stustanet/Luftmeter/PCB/luftmeter.jpg

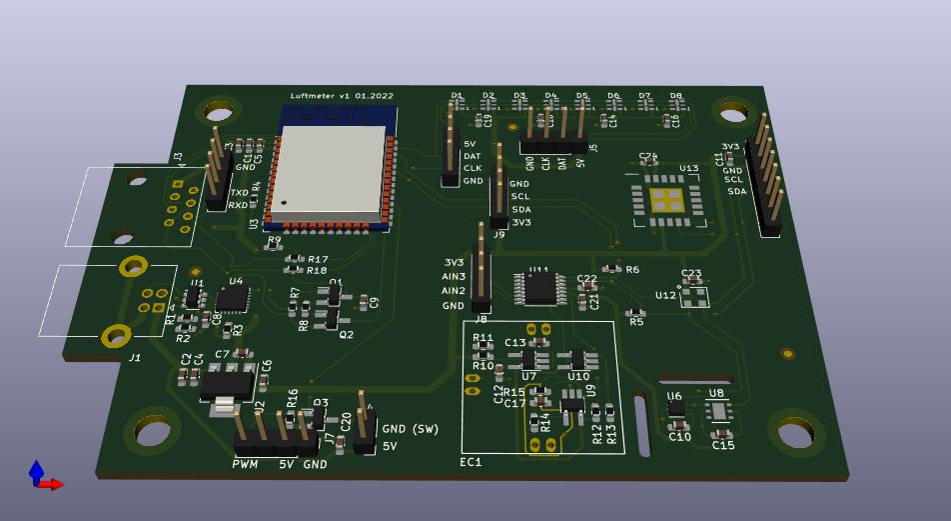
PCB/luftmeter.jpg
