stustanet/Luftmeter/PCB/plots/luftmeter.pdf

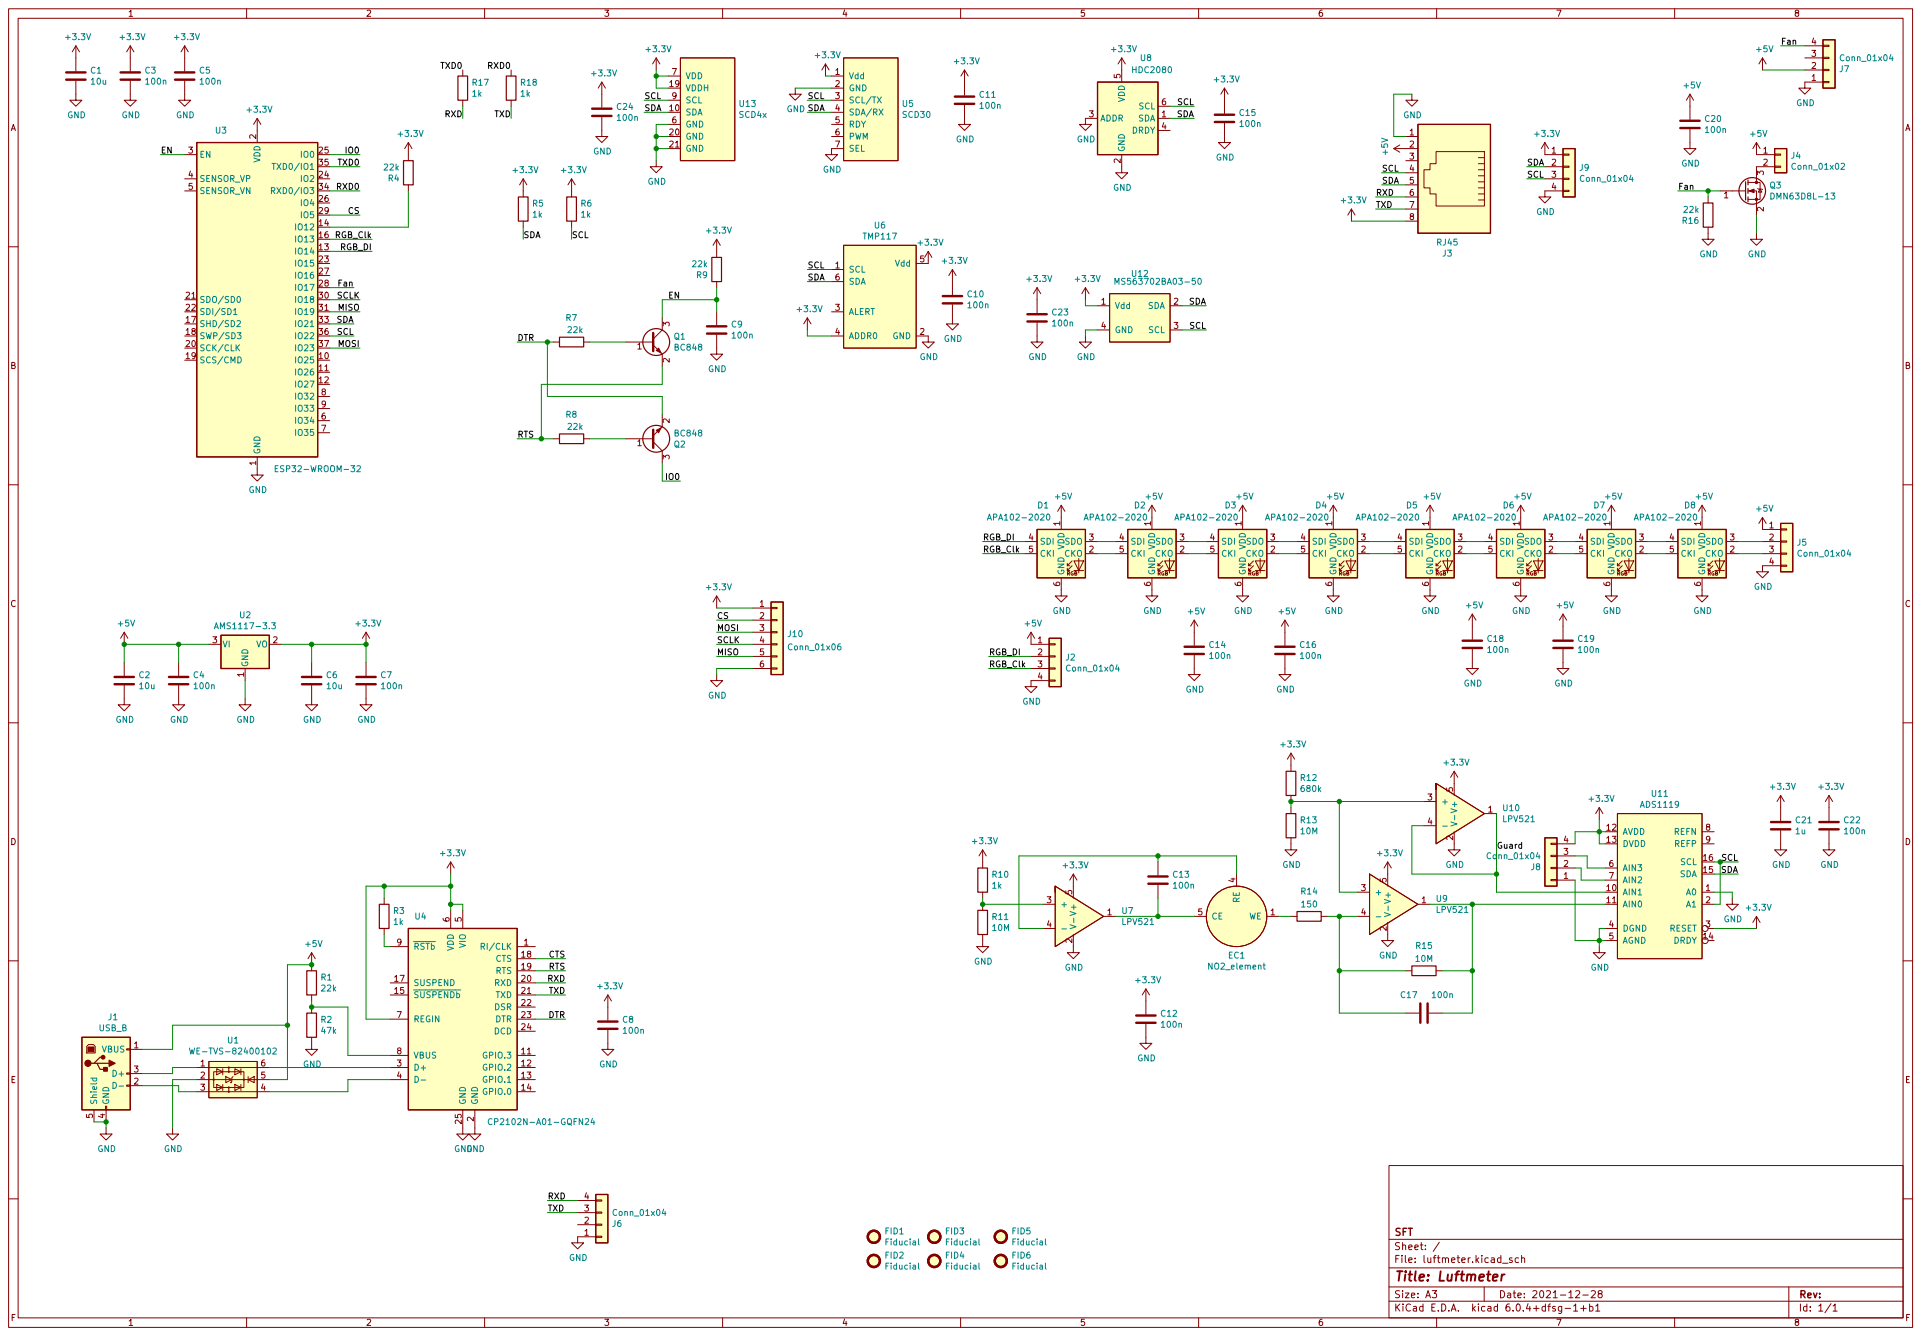
[picture p2: page 1]

2 SCK/CLK 20 SDO/SD0 21 SDI/SD1 22

1 CKO 2 SDO 3 SDI 4 CKI 5 GND

RGB VDD

2 RXD 20 TXD 21 DSR 22 DTR 23 DCD 24 GND 25 D+ 3 D- 4 VIO

File: luftmeter.kicad_sch Sheet: / SFT
