stustanet/Luftmeter/PCB/luftmeter.kicad_pcb

## KiCad design PCB/luftmeter.kicad_pcb (2022-04-28)

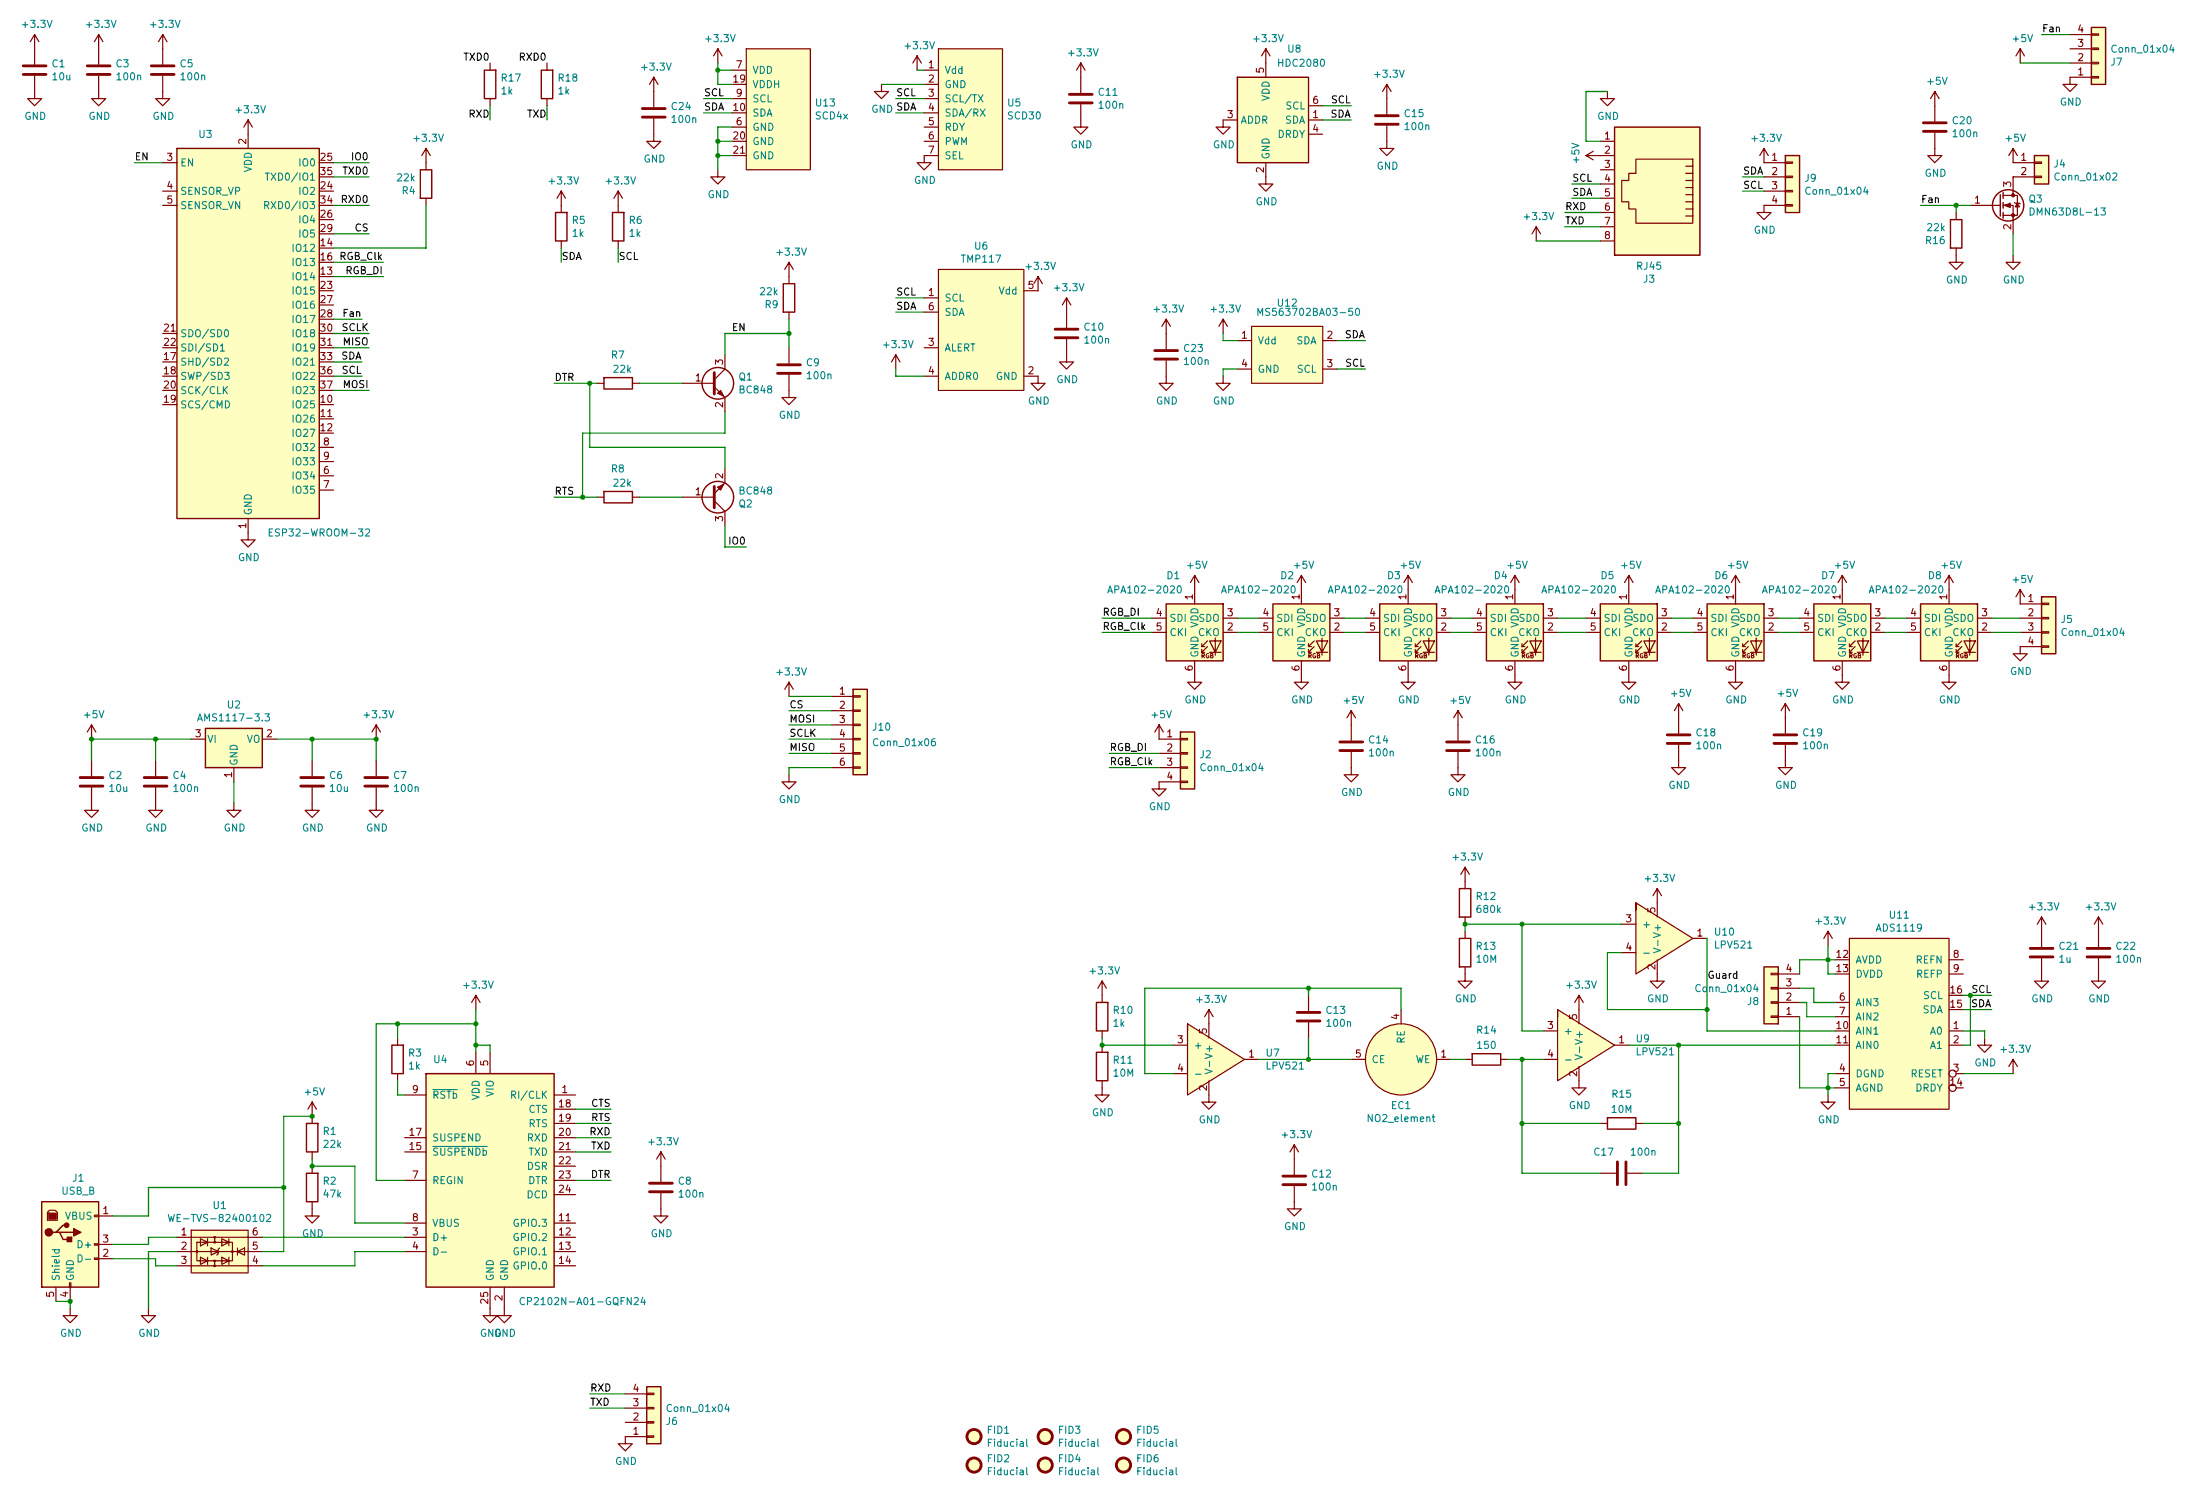
[picture p3: schematic luftmeter.kicad_sch]

Parts:
C1, C2, C6: 10u; C_0603_1608Metric_Pad1.08x0.95mm_HandSolder
C3, C4, C5, C7, C8, C9, C10, C11, C12, C13, C14, C15, C16, C17, C18, C19, C20, C22, C23, C24: 100n; C_0603_1608Metric_Pad1.08x0.95mm_HandSolder
C21: 1u; C_0603_1608Metric_Pad1.08x0.95mm_HandSolder
D1, D2, D3, D4, D5, D6, D7, D8: APA102-2020; LED-APA102-2020
EC1: NO2_element; SPEC_sensor_THT
FID1, FID2, FID3, FID4, FID5, FID6: Fiducial; Fiducial_1mm_Mask2mm
J1: USB_B; USB_B_Lumberg_2411_02_Horizontal; mouser 710-61400416121
J2, J5, J6, J7, J8, J9: Conn_01x04; PinHeader_1x04_P2.54mm_Vertical
J3: RJ45; RJ45_Amphenol_54602-x08_Horizontal; mouser 490-CRJ021-3-TH
J4: Conn_01x02; PinHeader_1x02_P2.54mm_Vertical
J10: Conn_01x06; PinSocket_1x06_P2.54mm_Vertical
Q1, Q2: BC848; SOT-23_Handsoldering
Q3: DMN63D8L-13; SOT-23_Handsoldering
R1, R4, R7, R8, R9, R16: 22k; R_0603_1608Metric_Pad0.98x0.95mm_HandSolder
R2: 47k; R_0603_1608Metric_Pad0.98x0.95mm_HandSolder
R3, R5, R6, R10, R17, R18: 1k; R_0603_1608Metric_Pad0.98x0.95mm_HandSolder
R11, R13, R15: 10M; R_0603_1608Metric_Pad0.98x0.95mm_HandSolder
R12: 680k; R_0603_1608Metric_Pad0.98x0.95mm_HandSolder
R14: 150; R_0603_1608Metric_Pad0.98x0.95mm_HandSolder
U1: WE-TVS-82400102; SOT-23-6
U2: AMS1117-3.3; SOT-223-3_TabPin2
U3: ESP32-WROOM-32
U4: CP2102N-A01-GQFN24; QFN-24-1EP_4x4mm_P0.5mm_EP2.6x2.6mm
U5: SCD30; SCD30_header
U6: TMP117; WSON-6-1EP_2x2mm_P0.65mm_EP1x1.6mm
U7, U9, U10: LPV521; TSOT-23-5_HandSoldering
U8: HDC2080; Texas_PWSON-N6
U11: ADS1119; TSSOP-16_4.4x5mm_P0.65mm
U12: MS563702BA03-50; TE_Baro_pres4
U13: SCD4x; QFN-20_EP_10.1x10.1_Pitch1.25mm

Connections:
+3V3: C1.1, C3.1, C5.1, C6.1, C7.1, C8.1, C10.1, C11.1, C12.1, C15.1, C21.1, C22.1, C23.1, C24.1, J3.8, J8.4, J9.1, J10.1, R3.2, R4.1, R5.2, R6.2, R9.1, R10.2, R12.1, U2.2 (VO), U3.2 (VDD), U4.5 (VIO), U4.6 (VDD), U4.7 (REGIN), U5.1 (Vdd), U6.4 (ADDR0), U6.5 (Vdd), U7.5 (V+), U8.5 (VDD), U9.5 (V+), U10.5 (V+), U11.3 (RESET), U11.12 (AVDD), U11.13 (DVDD), U12.1 (Vdd), U13.7 (VDD), U13.19 (VDDH)
+5V: C2.1, C4.1, C14.1, C16.1, C18.1, C19.1, C20.1, D1.1 (VDD), D2.1 (VDD), D3.1 (VDD), D4.1 (VDD), D5.1 (VDD), D6.1 (VDD), D7.1 (VDD), D8.1 (VDD), J1.1 (VBUS), J2.1, J3.2, J4.1, J5.1, J7.2, R1.2, U1.5, U2.3 (VI)
/CS: J10.2, U3.29 (IO5)
/CTS: U4.18 (CTS)
/DTR: Q2.2 (E), R7.2, U4.23 (DTR)
/EN: C9.1, Q1.3 (C), R9.2, U3.3 (EN)
/Fan: J7.4, Q3.1 (G), R16.1, U3.28 (IO17)
/Guard: U10.1, U10.4 (-), U11.10 (AIN1)
/IO0: Q2.3 (C), U3.25 (IO0)
/MISO: J10.5, U3.31 (IO19)
/MOSI: J10.3, U3.37 (IO23)
/RGB_Clk: D1.5 (CKI), J2.3, U3.16 (IO13)
/RGB_DI: D1.4 (SDI), J2.2, U3.13 (IO14)
/RTS: Q1.2 (E), R8.2, U4.19 (RTS)
/RXD: J3.6, J6.4, R17.1, U4.20 (RXD)
/RXD0: R18.2, U3.34 (RXD0/IO3)
/SCL: J3.4, J9.3, R6.1, U3.36 (IO22), U5.3 (SCL/TX), U6.1 (SCL), U8.6 (SCL), U11.2 (A1), U11.16 (SCL), U12.3 (SCL), U13.9 (SCL)
/SCLK: J10.4, U3.30 (IO18)
/SDA: J3.5, J9.2, R5.1, U3.33 (IO21), U5.4 (SDA/RX), U6.6 (SDA), U8.1 (SDA), U11.15 (SDA), U12.2 (SDA), U13.10 (SDA)
/TXD: J3.7, J6.3, R18.1, U4.21 (TXD)
/TXD0: R17.2, U3.35 (TXD0/IO1)
GND: C1.2, C2.2, C3.2, C4.2, C5.2, C6.2, C7.2, C8.2, C9.2, C10.2, C11.2, C12.2, C14.2, C15.2, C16.2, C18.2, C19.2, C20.2, C21.2, C22.2, C23.2, C24.2, D1.6 (GND), D2.6 (GND), D3.6 (GND), D4.6 (GND), D5.6 (GND), D6.6 (GND), D7.6 (GND), D8.6 (GND), J1.4 (GND), J1.5 (Shield), J2.4, J3.1, J5.4, J6.1, J7.1, J8.1, J9.4, J10.6, Q3.2 (S), R2.1, R11.1, R13.2, R16.2, U1.2, U2.1 (GND), U3.1 (GND), U3.15 (GND), U3.38 (GND), U3.39 (GND), U4.2 (GND), U4.25 (GND), U5.2 (GND), U5.7 (SEL), U6.2 (GND), U7.2 (V-), U8.2 (GND), U8.3 (ADDR), U9.2 (V-), U10.2 (V-), U11.1 (A0), U11.4 (DGND), U11.5 (AGND), U12.4 (GND), U13.6 (GND), U13.20 (GND), U13.21 (GND)
unnamed: C13.1, EC1.4 (RE), U7.4 (-)
unnamed: C13.2, EC1.5 (CE), U7.1
unnamed: C17.1, R14.1, R15.2, U9.4 (-)
unnamed: C17.2, R15.1, U9.1, U11.11 (AIN0)
unnamed: D1.2 (CKO), D2.5 (CKI)
unnamed: D1.3 (SDO), D2.4 (SDI)
unnamed: D2.2 (CKO), D3.5 (CKI)
unnamed: D2.3 (SDO), D3.4 (SDI)
unnamed: D3.2 (CKO), D4.5 (CKI)
unnamed: D3.3 (SDO), D4.4 (SDI)
unnamed: D4.2 (CKO), D5.5 (CKI)
unnamed: D4.3 (SDO), D5.4 (SDI)
unnamed: D5.2 (CKO), D6.5 (CKI)
unnamed: D5.3 (SDO), D6.4 (SDI)
unnamed: D6.2 (CKO), D7.5 (CKI)
unnamed: D6.3 (SDO), D7.4 (SDI)
unnamed: D7.2 (CKO), D8.5 (CKI)
unnamed: D7.3 (SDO), D8.4 (SDI)
unnamed: D8.2 (CKO), J5.3
unnamed: D8.3 (SDO), J5.2
unnamed: EC1.1 (WE), R14.2
unnamed: J1.2 (D-), U1.3
unnamed: J1.3 (D+), U1.1
unnamed: J4.2, Q3.3 (D)
unnamed: J8.2, U11.7 (AIN2)
unnamed: J8.3, U11.6 (AIN3)
unnamed: Q1.1 (B), R7.1
unnamed: Q2.1 (B), R8.1
unnamed: R1.1, R2.2, U4.8 (VBUS)
unnamed: R3.1, U4.9 (~RSTb)
unnamed: R4.2, U3.14 (IO12)
unnamed: R10.1, R11.2, U7.3 (+)
unnamed: R12.2, R13.1, U9.3 (+), U10.3 (+)
unnamed: U1.4, U4.4 (D-)
unnamed: U1.6, U4.3 (D+)

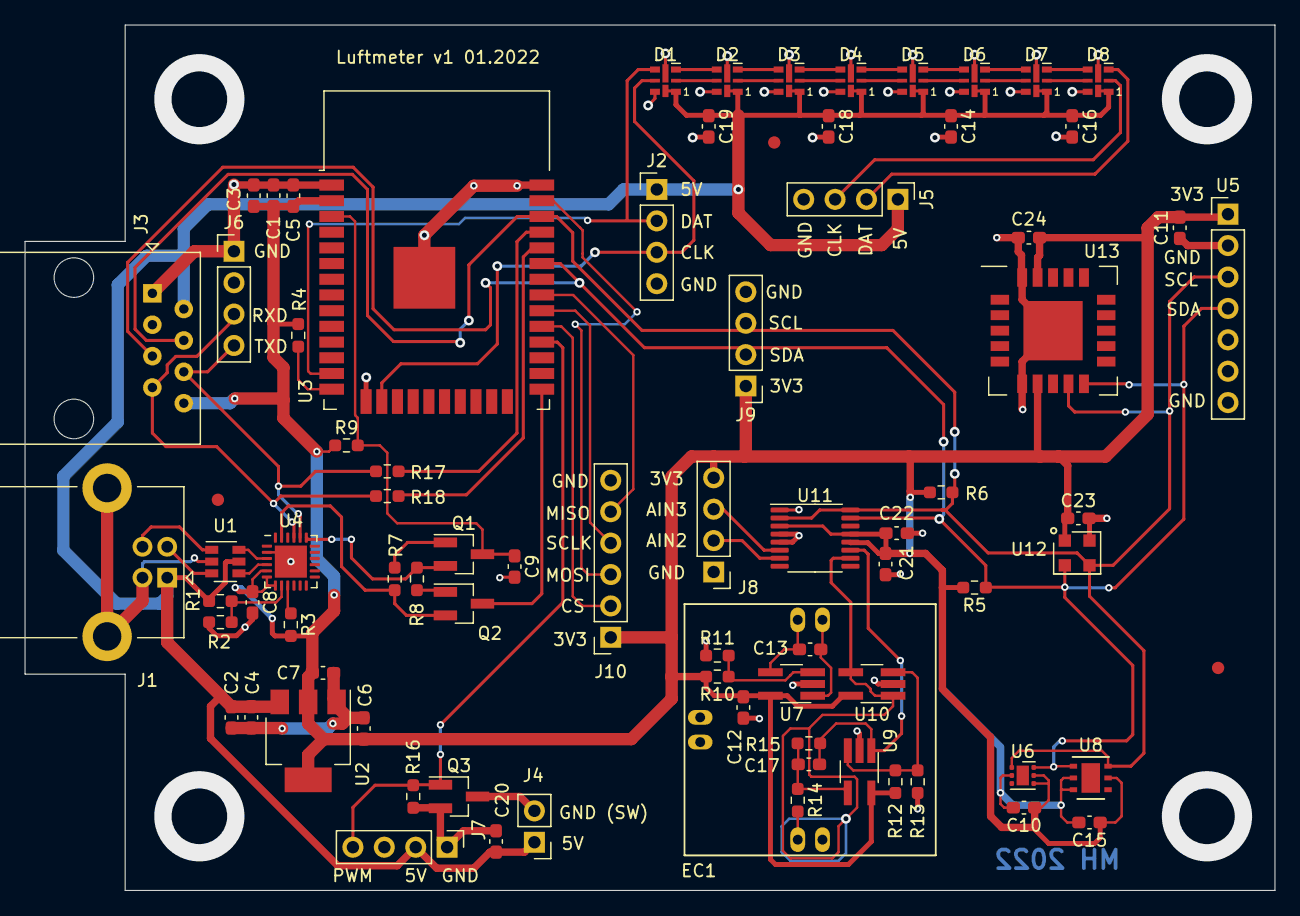
[picture p4: board luftmeter.kicad_pcb from above]

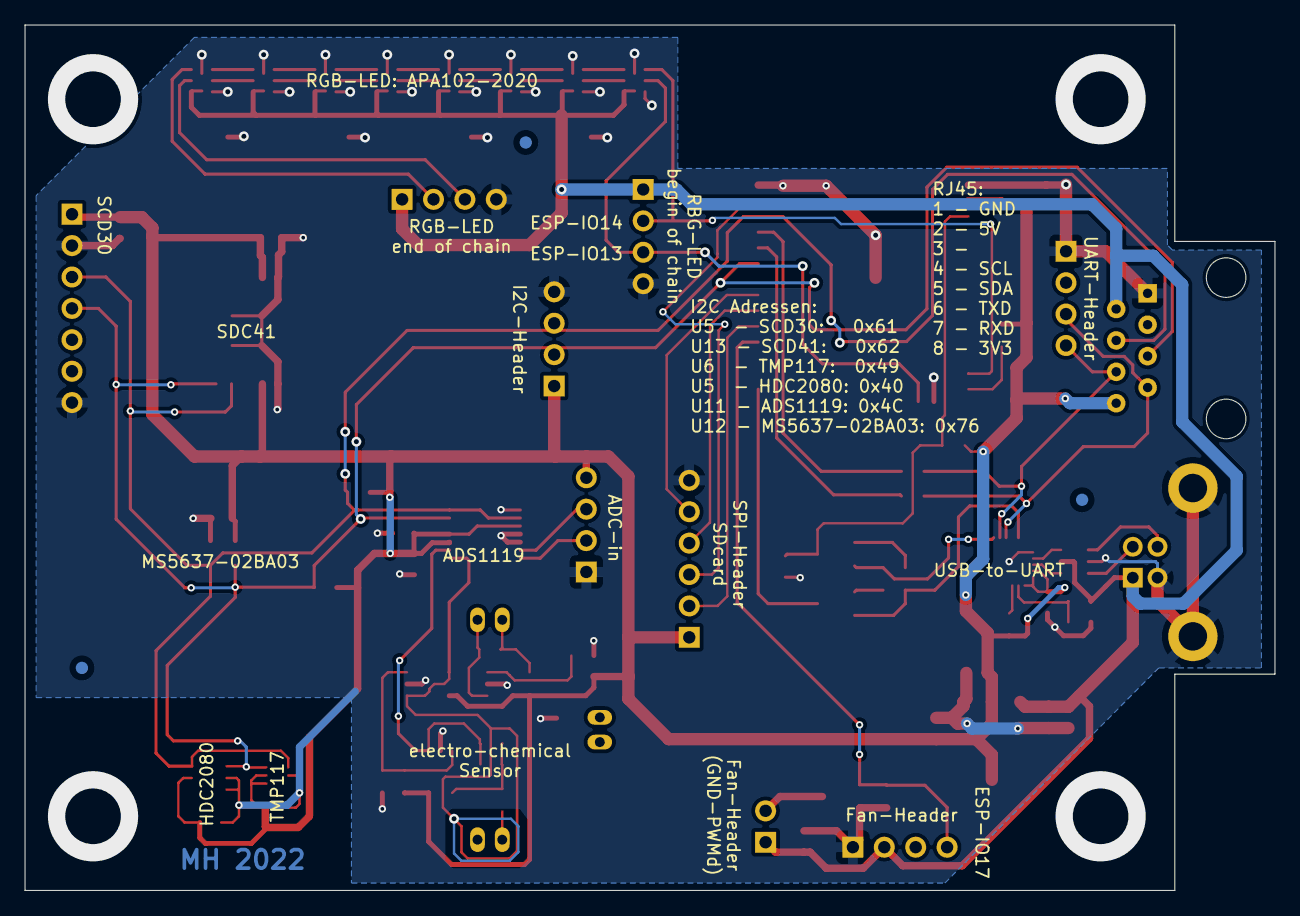
[picture p5: board luftmeter.kicad_pcb from below]

Board: 2 copper layers, 101.1 x 70.0 mm, 83 parts (3 on the bottom side), 56 nets.
